mikefsq/x1500_gps_12v/mech/x1500_top_case.step

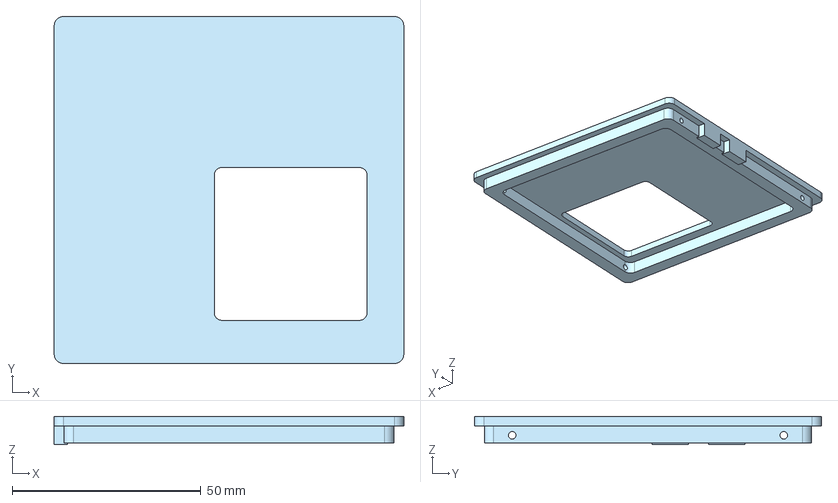
[picture p2: CAD file, 2026-11-01]
mech/x1500_top_case.step
92.7 x 92.0 x 7.45 mm
