mikefsq/x1500_gps_12v/mech/x1500_bot_case.step

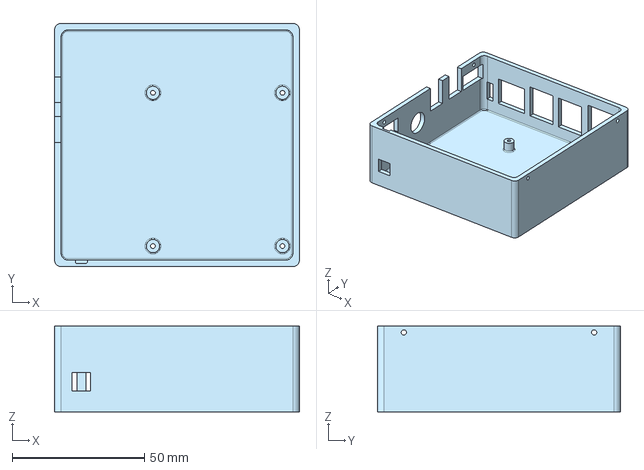
[picture p3: CAD file, 2026-11-01]
mech/x1500_bot_case.step
92.7 x 92.0 x 32.5 mm
