mikefsq/x1500_gps_12v/pcb/pi_mount_gps.kicad_pcb

## KiCad design pcb/pi_mount_gps.kicad_pcb (2026-11-01)

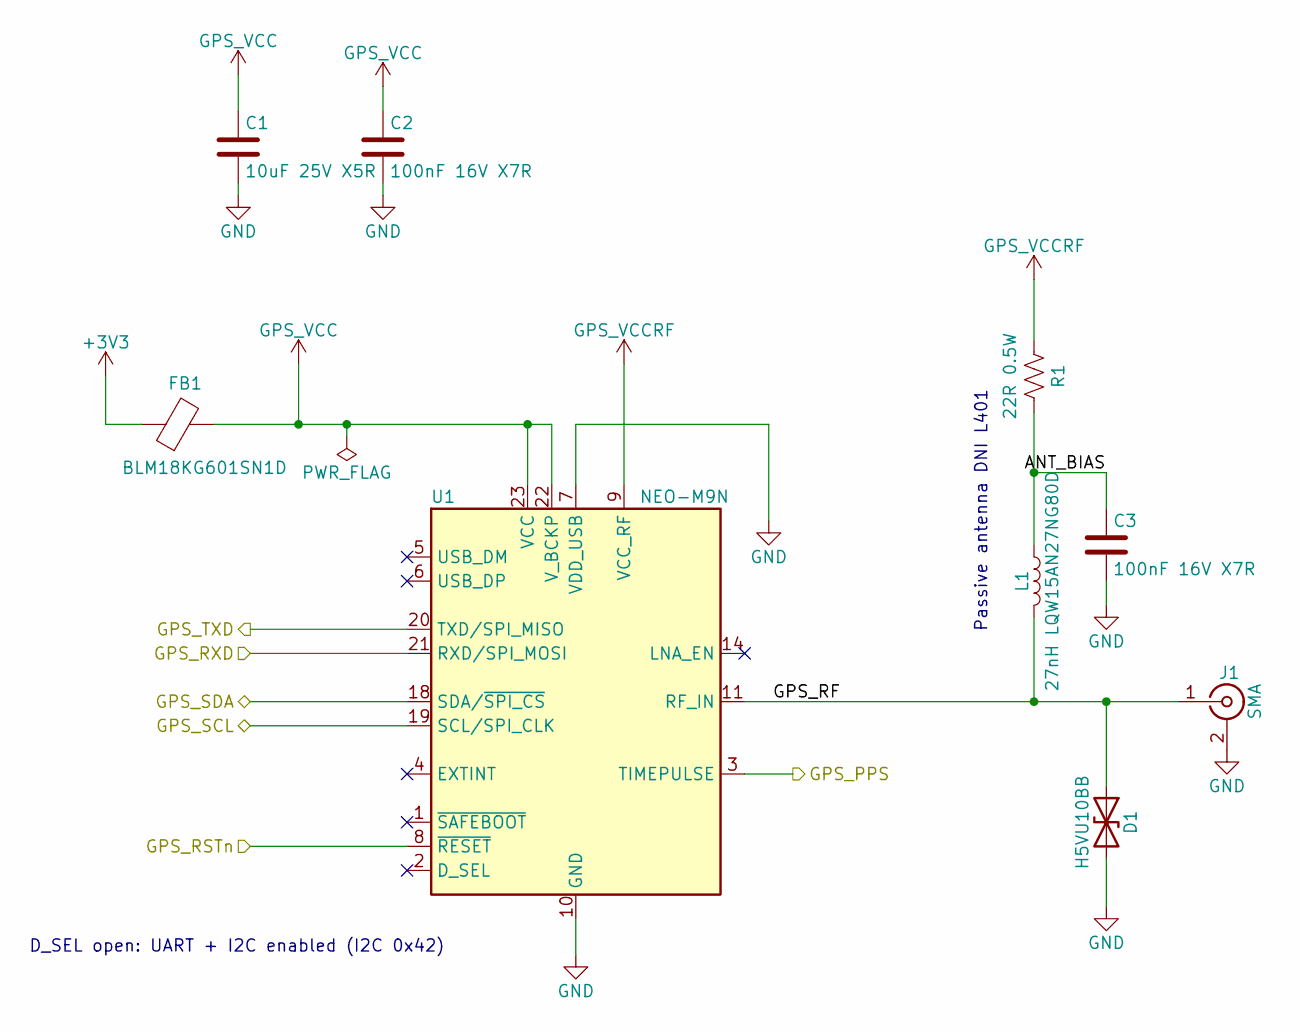
[picture p4: schematic gps.kicad_sch]

Parts:
C1: 10uF 25V X5R; C_0805_2012Metric; LCSC C15850
C2, C3: 100nF 16V X7R; C_0402_1005Metric; LCSC C1525
D1: H5VU10BB; D_0402_1005Metric; LCSC C20615786
FB1: BLM18KG601SN1D; L_0603_1608Metric; LCSC C85833
J1: SMA; SMA_Molex_73251-1153_EdgeMount_Horizontal
L1: 27nH LQW15AN27NG80D; L_0402_1005Metric; LCSC C882469
R1: 22R 0.5W; R_1206_3216Metric; LCSC C2845146
U1: NEO-M9N; ublox_NEO; LCSC C5119087

Connections:
+3V3: FB1.1; also elsewhere on the board
/GPS/ANT_BIAS: C3.1, L1.1, R1.2
/GPS/GPS_RF: D1.1 (A1), J1.1 (In), L1.2, U1.11 (RF_IN)
/GPS_PPS: U1.3 (TIMEPULSE); also elsewhere on the board
/GPS_RSTn: U1.8 (~RESET); also elsewhere on the board
/GPS_RXD: U1.21 (RXD/SPI_MOSI); also elsewhere on the board
/GPS_TXD: U1.20 (TXD/SPI_MISO); also elsewhere on the board
/I2C1_SCL: U1.19 (SCL/SPI_CLK); also elsewhere on the board
/I2C1_SDA: U1.18 (SDA/~SPI_CS); also elsewhere on the board
GND: C1.2, C2.2, C3.2, D1.2 (A2), J1.2 (Ext), U1.7 (VDD_USB), U1.10 (GND), U1.12 (GND), U1.13 (GND), U1.24 (GND); also elsewhere on the board
GPS_VCC: C1.1, C2.1, FB1.2, U1.22 (V_BCKP), U1.23 (VCC)
GPS_VCCRF: R1.1, U1.9 (VCC_RF)

Notes on the sheet:
D_SEL open: UART + I2C enabled (I2C 0x42)
Passive antenna DNI L401

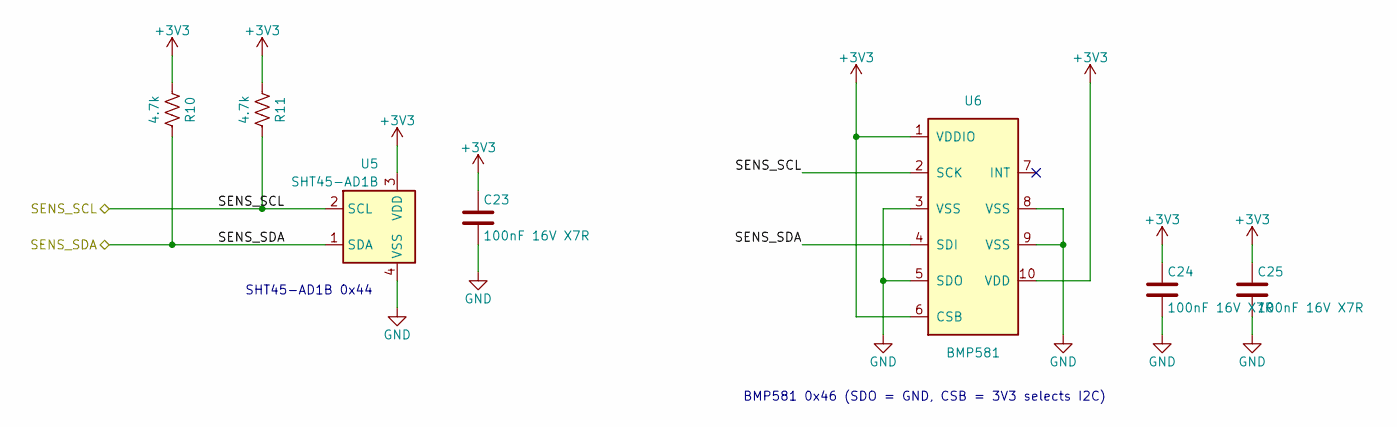
[picture p5: schematic sensors.kicad_sch]

Parts:
C23, C24, C25: 100nF 16V X7R; C_0402_1005Metric; LCSC C1525
R10, R11: 4.7k; R_0402_1005Metric; LCSC C25900
U5: SHT45-AD1B; Sensirion_DFN-4_1.5x1.5mm_P0.8mm_SHT4x_NoCentralPad; LCSC C5221601
U6: BMP581; Bosch_LGA-10_2x2mm_P0.5mm_BMP581; LCSC C5362283

Connections:
+3V3: C23.1, C24.1, C25.1, R10.1, R11.1, U5.3 (VDD), U6.1 (VDDIO), U6.6 (CSB), U6.10 (VDD); also elsewhere on the board
/I2C1_SCL: R11.2, U5.2 (SCL), U6.2 (SCK); also elsewhere on the board
/I2C1_SDA: R10.2, U5.1 (SDA), U6.4 (SDI); also elsewhere on the board
GND: C23.2, C24.2, C25.2, U5.4 (VSS), U6.3 (VSS), U6.5 (SDO), U6.8 (VSS), U6.9 (VSS); also elsewhere on the board

Notes on the sheet:
BMP581 0x46 (SDO = GND, CSB = 3V3 selects I2C)
SHT45-AD1B 0x44

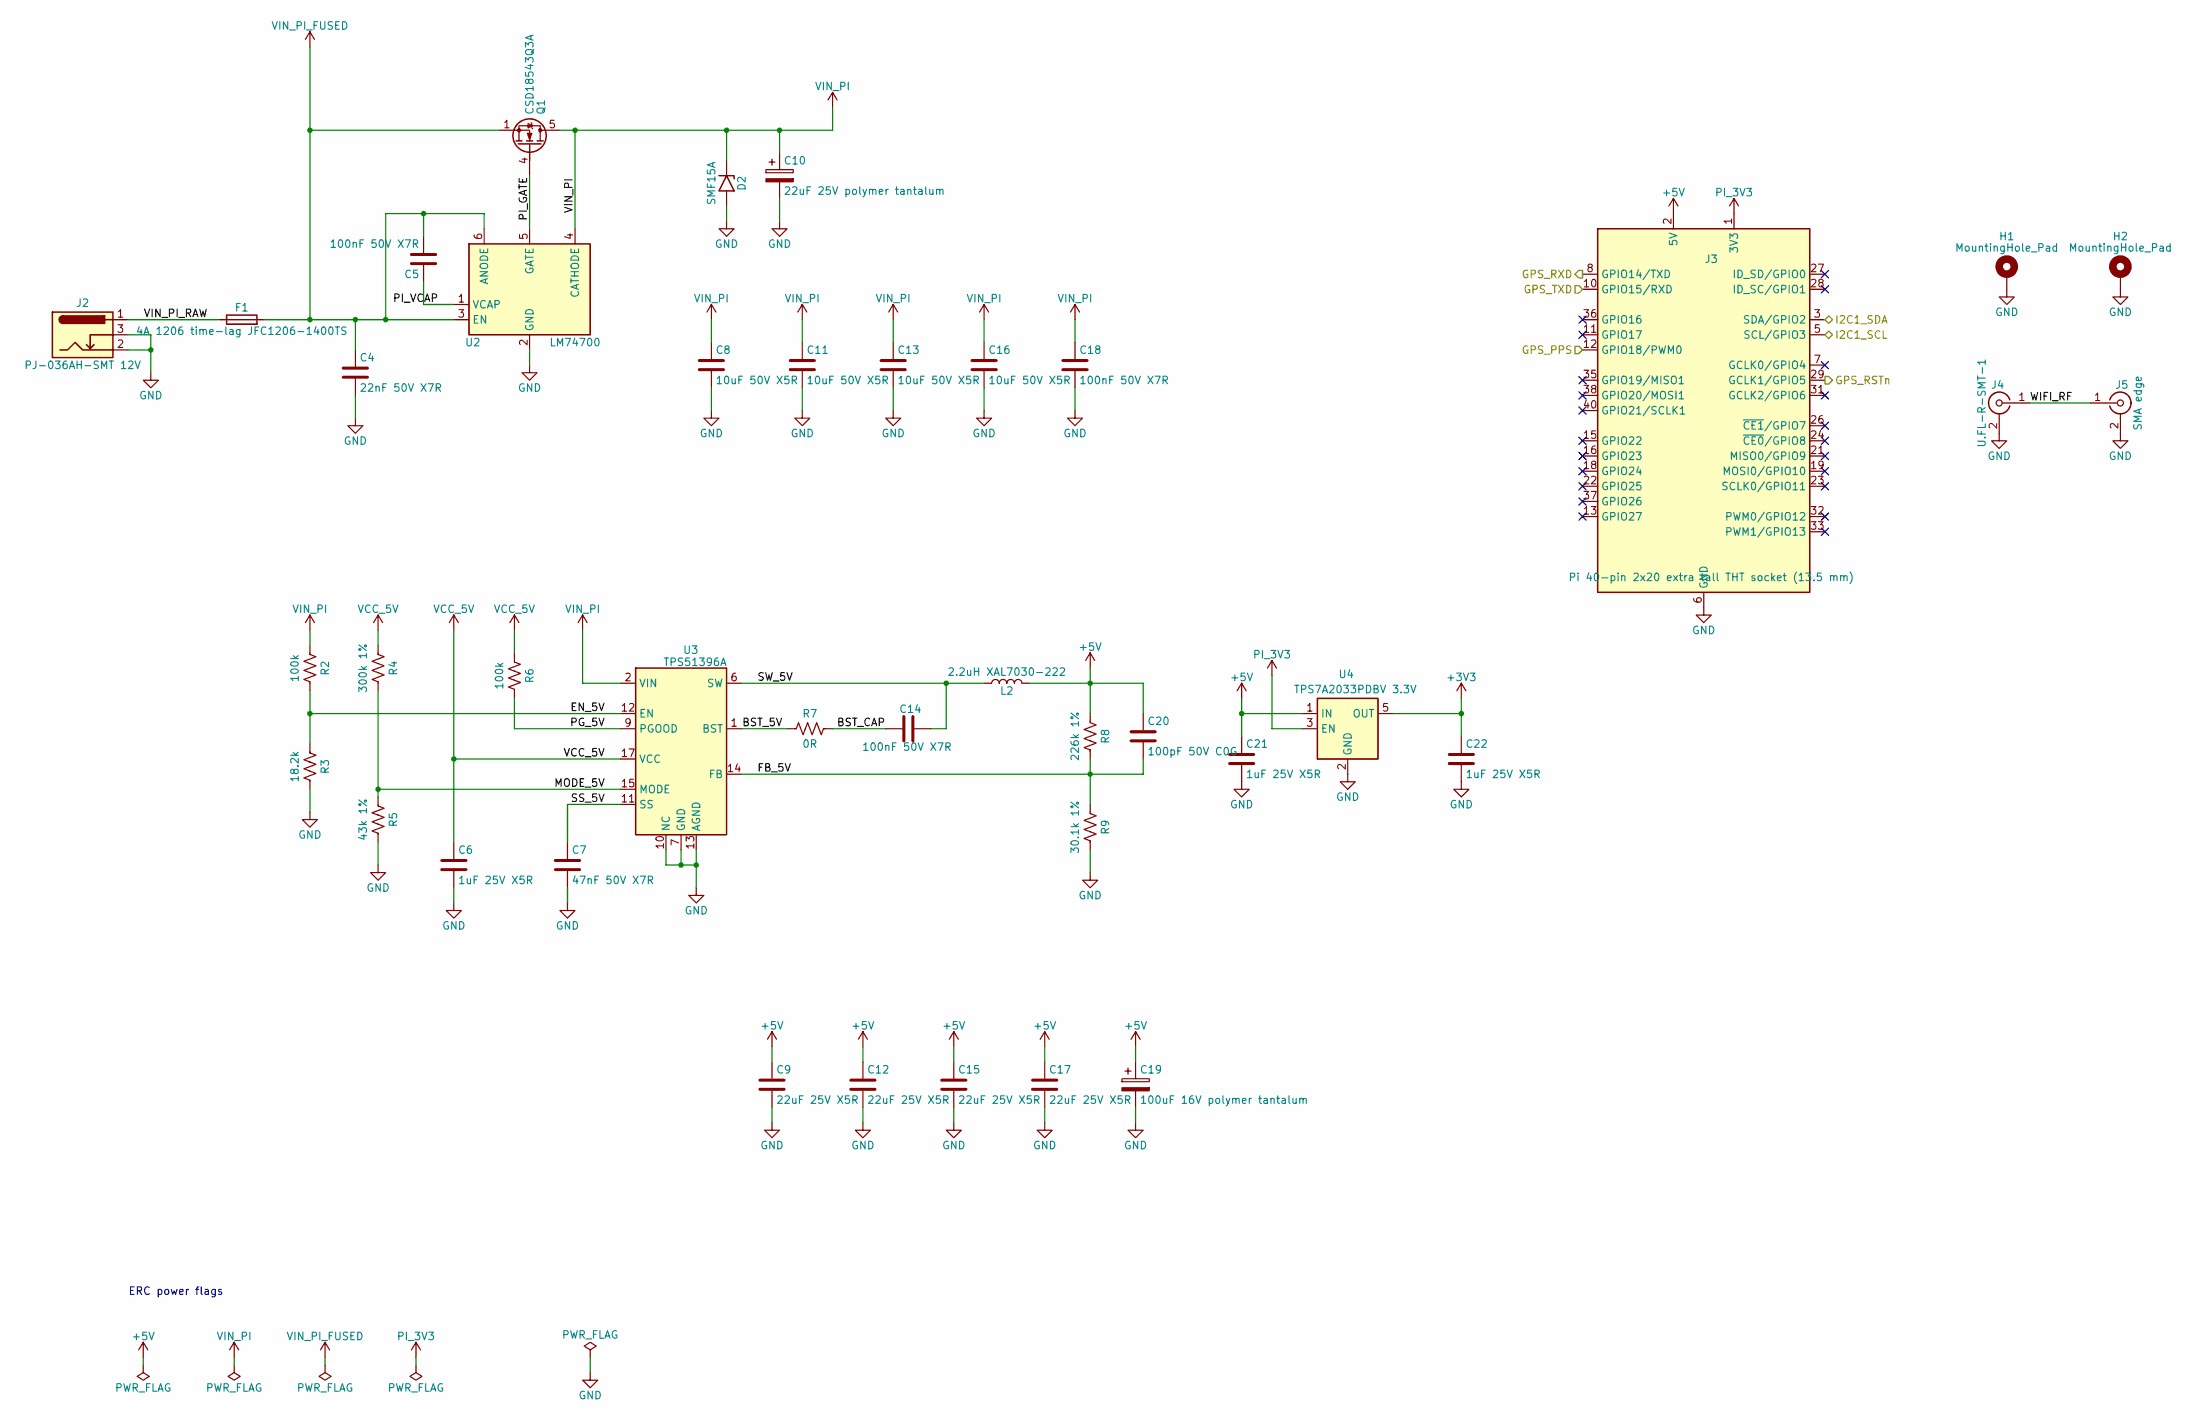
[picture p6: schematic pi5v.kicad_sch]

Parts:
C4: 22nF 50V X7R; C_0402_1005Metric; LCSC C1532
C5, C14, C18: 100nF 50V X7R; C_0402_1005Metric; LCSC C307331
C6, C21, C22: 1uF 25V X5R; C_0402_1005Metric; LCSC C52923
C7: 47nF 50V X7R; C_0402_1005Metric; LCSC C880605
C8, C11, C13, C16: 10uF 50V X5R; C_0805_2012Metric; LCSC C440198
C9, C12, C15, C17: 22uF 25V X5R; C_1206_3216Metric; LCSC C12891
C10: 22uF 25V polymer tantalum; CP_EIA-3528-21_Kemet-B; LCSC C696813
C19: 100uF 16V polymer tantalum; CP_EIA-7343-31_Kemet-D; LCSC C212713
C20: 100pF 50V C0G; C_0402_1005Metric; LCSC C1546
D2: SMF15A; D_SOD-123F; LCSC C19077509
F1: 4A 1206 time-lag JFC1206-1400TS; Fuse_1206_3216Metric; LCSC C52204055
H1, H2: MountingHole_Pad; MountingHole_2.7mm_M2.5_Pad_Via
J2: PJ-036AH-SMT 12V; BarrelJack_SameSky_PJ-036AH-SMT_Horizontal
J3: Pi 40-pin 2x20 extra tall THT socket (13.5 mm); PinSocket_2x20_P2.54mm_Vertical
J4: U.FL-R-SMT-1; U.FL_Hirose_U.FL-R-SMT-1_Vertical; LCSC C88374
J5: SMA edge; SMA_Molex_73251-1153_EdgeMount_Horizontal
L2: 2.2uH XAL7030-222; L_Coilcraft_XAL7030-222; LCSC C19191686
Q1: CSD18543Q3A; VSON-8_3.3x3.3mm_P0.65mm_NexFET; LCSC C840100
R2, R6: 100k; R_0402_1005Metric; LCSC C25741
R3: 18.2k; R_0402_1005Metric; LCSC C2998079
R4: 300k 1%; R_0402_1005Metric; LCSC C25774
R5: 43k 1%; R_0402_1005Metric; LCSC C54920674
R7: 0R; R_0402_1005Metric; LCSC C17168
R8: 226k 1%; R_0402_1005Metric; LCSC C5121518
R9: 30.1k 1%; R_0402_1005Metric; LCSC C2998131
U2: LM74700; SOT-23-6; LCSC C2653623
U3: TPS51396A; Texas_RJE0020A_VQFN-20-1EP_3x3mm_P0.45mm_EP0.675x0.76mm; LCSC C3032872
U4: TPS7A2033PDBV 3.3V; SOT-23-5; LCSC C2862740

Connections:
+3V3: C22.1, U4.5 (OUT); also elsewhere on the board
+5V: C9.1, C12.1, C15.1, C17.1, C19.1, C20.1, C21.1, J3.2 (5V), J3.4 (5V), L2.2, R8.1, U4.1 (IN)
/GPS_PPS: J3.12 (GPIO18/PWM0); also elsewhere on the board
/GPS_RSTn: J3.29 (GCLK1/GPIO5); also elsewhere on the board
/GPS_RXD: J3.8 (GPIO14/TXD); also elsewhere on the board
/GPS_TXD: J3.10 (GPIO15/RXD); also elsewhere on the board
/I2C1_SCL: J3.5 (SCL/GPIO3); also elsewhere on the board
/I2C1_SDA: J3.3 (SDA/GPIO2); also elsewhere on the board
/Pi 5V/BST_5V: R7.1, U3.1 (BST)
/Pi 5V/BST_CAP: C14.1, R7.2
/Pi 5V/EN_5V: R2.2, R3.1, U3.12 (EN)
/Pi 5V/FB_5V: C20.2, R8.2, R9.1, U3.14 (FB)
/Pi 5V/MODE_5V: R4.2, R5.1, U3.15 (MODE)
/Pi 5V/PG_5V: R6.2, U3.9 (PGOOD)
/Pi 5V/PI_GATE: Q1.4 (G), U2.5 (GATE)
/Pi 5V/PI_VCAP: C5.1, U2.1 (VCAP)
/Pi 5V/SS_5V: C7.1, U3.11 (SS)
/Pi 5V/SW_5V: C14.2, L2.1, U3.6 (SW), U3.19 (SW), U3.20 (SW)
/Pi 5V/VIN_PI_RAW: F1.1, J2.1
/Pi 5V/WIFI_RF: J4.1 (In), J5.1 (In)
GND: C4.2, C6.2, C7.2, C8.2, C9.2, C10.2, C11.2, C12.2, C13.2, C15.2, C16.2, C17.2, C18.2, C19.2, C21.2, C22.2, D2.2 (A2), H1.1 (1_1), H2.1 (1_1), J2.2, J2.3, J3.6 (GND), J3.9 (GND), J3.14 (GND), J3.20 (GND), J3.25 (GND), J3.30 (GND), J3.34 (GND), J3.39 (GND), J4.2 (Ext), J5.2 (Ext), R3.2, R5.2, R9.2, U2.2 (GND), U3.7 (GND), U3.8 (GND), U3.10 (NC), U3.13 (AGND), U3.16 (NC), U3.18 (GND), U3.21 (GND), U4.2 (GND); also elsewhere on the board
PI_3V3: J3.1 (3V3), J3.17 (3V3), U4.3 (EN)
VCC_5V: C6.1, R4.1, R6.1, U3.17 (VCC)
VIN_PI: C8.1, C10.1, C11.1, C13.1, C16.1, C18.1, D2.1 (A1), Q1.5 (D), R2.1, U2.4 (CATHODE), U3.2 (VIN), U3.3 (VIN), U3.4 (VIN), U3.5 (VIN)
VIN_PI_FUSED: C4.1, C5.2, F1.2, Q1.1 (S), Q1.2 (S), Q1.3 (S), U2.3 (EN), U2.6 (ANODE)

Notes on the sheet:
ERC power flags

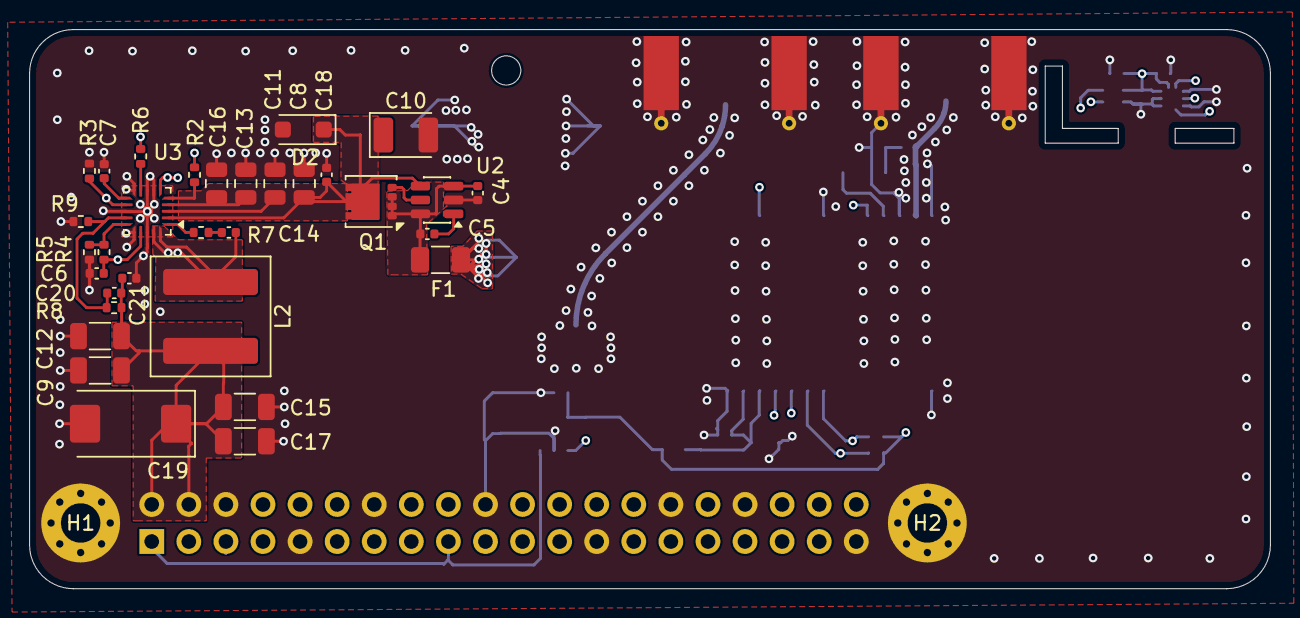
[picture p7: board pi_mount_gps.kicad_pcb from above]

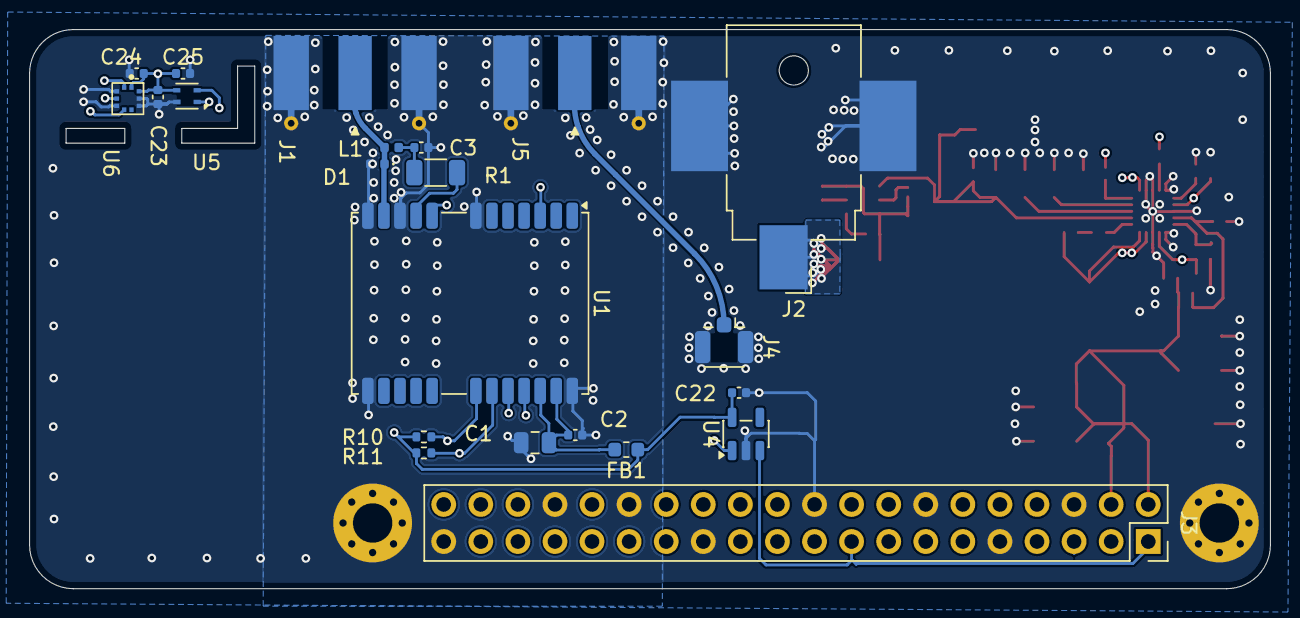
[picture p8: board pi_mount_gps.kicad_pcb from below]

Board: 4 copper layers, 85.0 x 38.3 mm, 56 parts (22 on the bottom side), 29 nets.
